JayB545/Teensy-Ultrasonic-Stereo-Recorder/Pictures/Assembled boards 1000017443.jpg

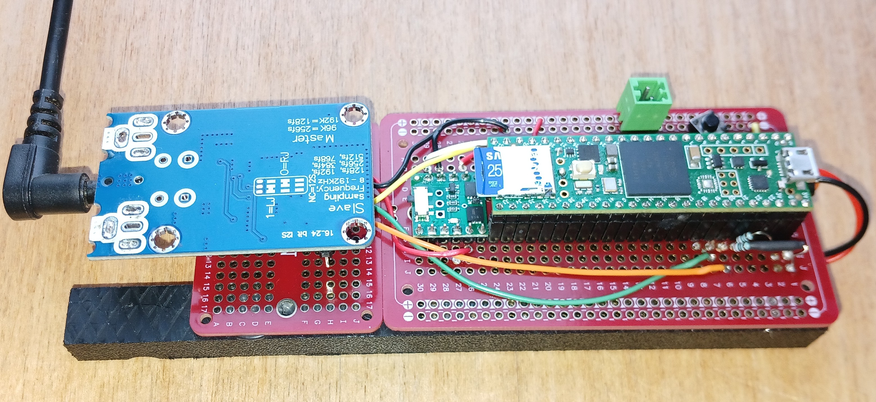
Pictures/Assembled boards 1000017443.jpg
