JayB545/Teensy-Ultrasonic-Stereo-Recorder/Pictures/Teensy & bridge board 1000017446.jpg

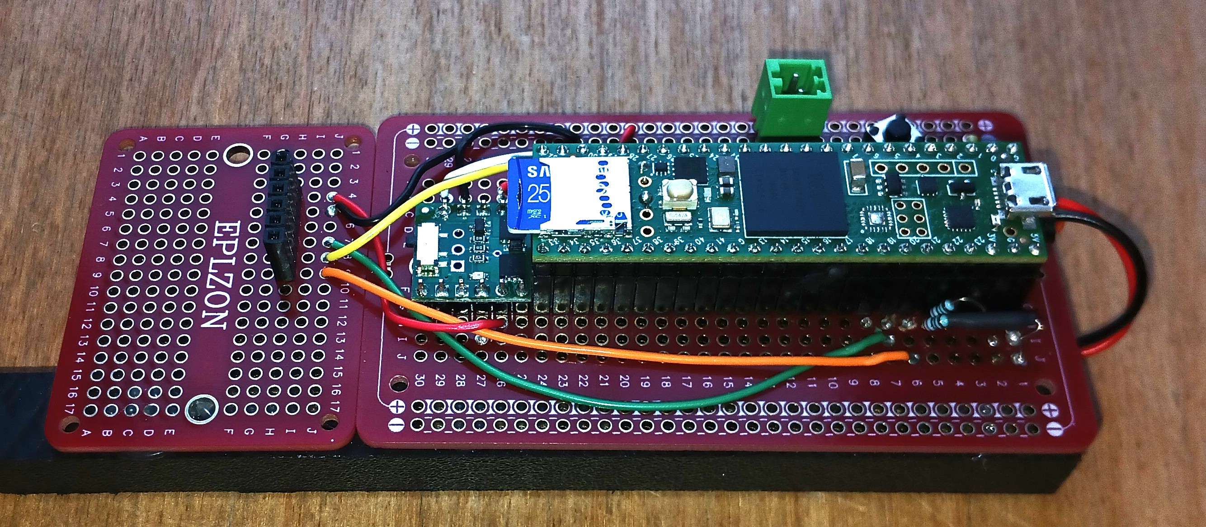
Pictures/Teensy & bridge board 1000017446.jpg
