JayB545/Teensy-Ultrasonic-Stereo-Recorder/Pictures/ADCmodule 1000017445.jpg

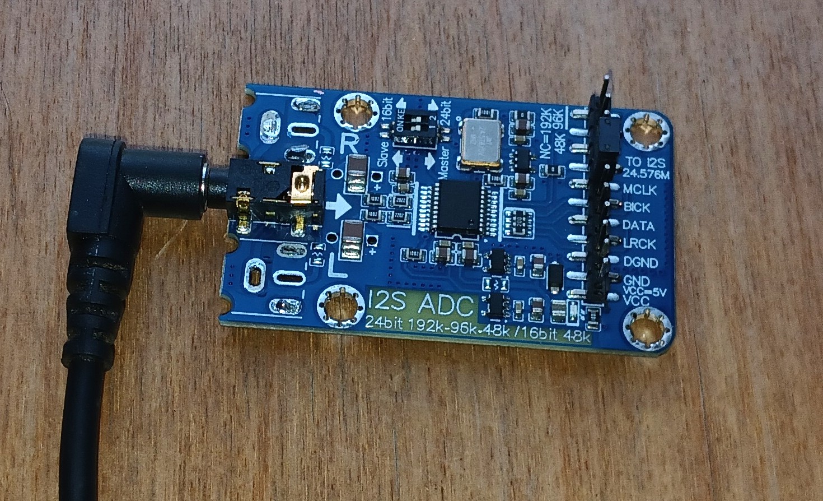
Pictures/ADCmodule 1000017445.jpg
