JayB545/Teensy-Ultrasonic-Stereo-Recorder/Pictures/Breadboard backside with RTC battery 1000017447.jpg

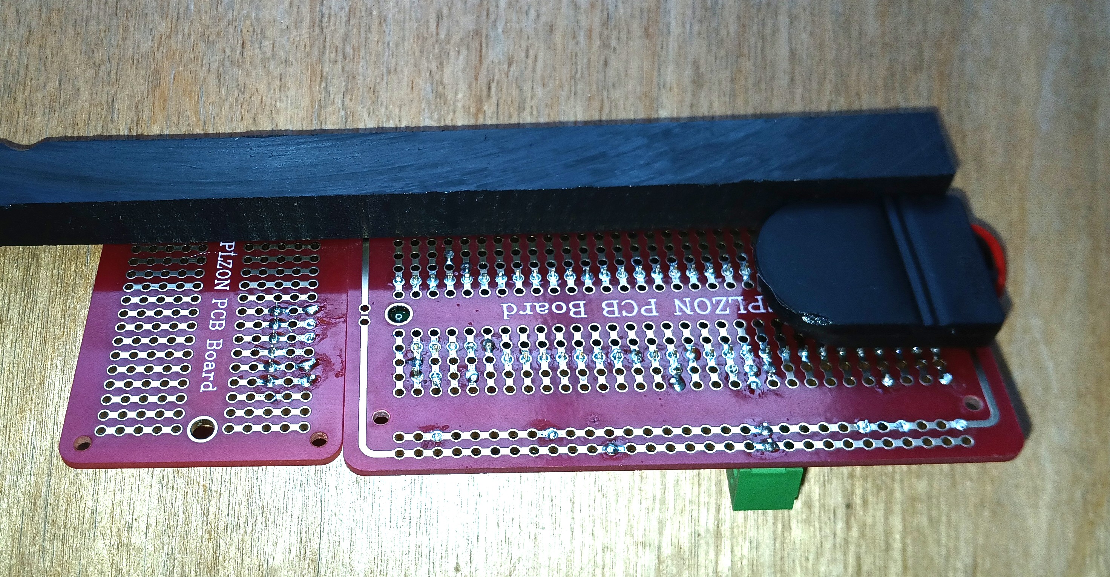
Pictures/Breadboard backside with RTC battery 1000017447.jpg
