JayB545/Teensy-Ultrasonic-Stereo-Recorder/Pictures/NoiseFloor dB re FullScale.png

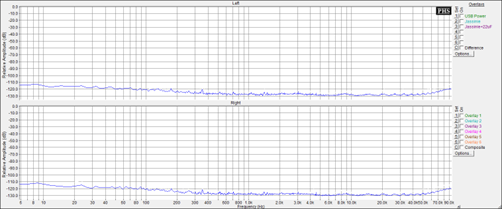
Pictures/NoiseFloor dB re FullScale.png
