JayB545/Teensy-Ultrasonic-Stereo-Recorder/(commit log)

2026-03-22 Rename Assembled boards 1000017443.jpg to Pictures/Assembled boards 1000017443.jpg
2026-03-22 Rename Breadboard backside with RTC battery 1000017447.jpg to Pictures/Breadboard backside with RTC battery 1000017447.jpg
2026-03-22 Rename Teensy & bridge board 1000017446.jpg to Pictures/Teensy & bridge board 1000017446.jpg
